cbm-instructions/evolition/images/Innenaufbau_obere_Box/Innenaufbau_obere_Box.jpg

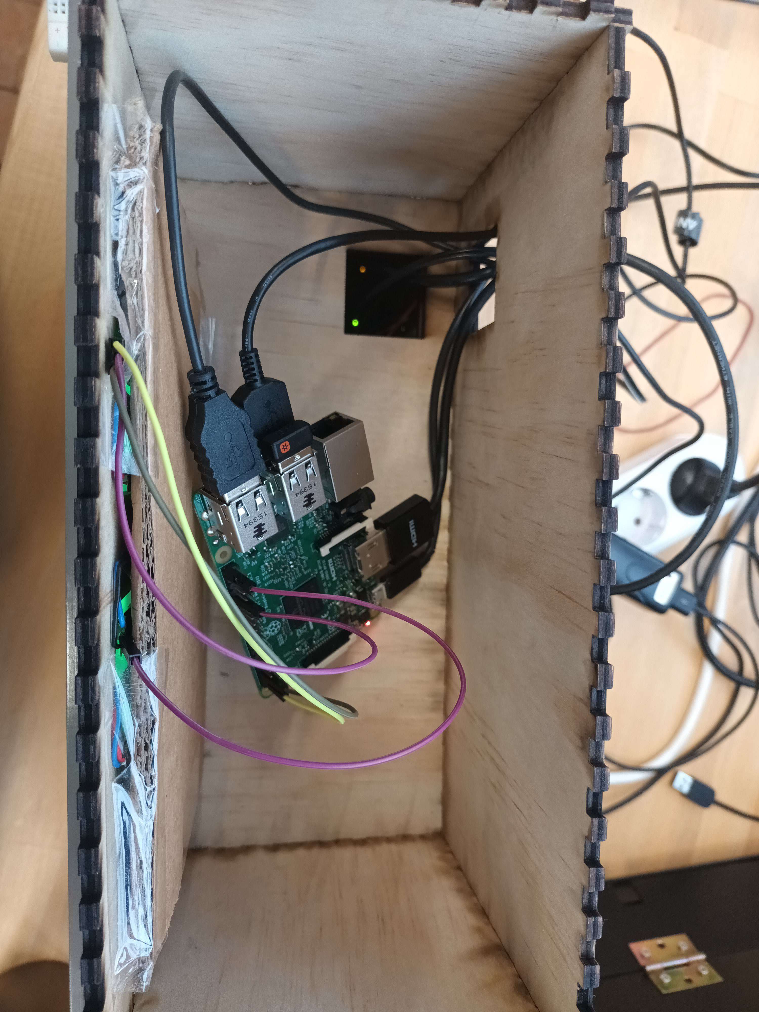
images/Innenaufbau_obere_Box/Innenaufbau_obere_Box.jpg
