cbm-instructions/evolition/Software/WeimosD1Mini/PeopleCounterFirmware/Config.h

#ifndef CONFIG_H
#define CONFIG_H

#define DEFAULT_PEOPLE_LIMIT 50
#define MOUNTED_INSIDE

/***   WiFi   ***/
//#define AP_MODE Does not work reliably
#define STASSID "name"
#define STAPSK "password"

/***   Debugging Mode   ***/
#define DEBUG_COUNTER

#endif
