cbm-instructions/evolition/Software/RaspberryPi/getExamTables.py

#!/usr/bin/env python3
import requests
import pandas as pd
import pdfplumber
import os 
import glob 


path = os.getcwd() + '/examTables/'


def getExamIB():
    url = 'https://services.informatik.hs-mannheim.de/pruefungsplan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'
    field = 'IB.pdf'
    getExamTable(url, field)
    getExamCSV(field)
    

def getExamCSB():
    url = 'https://services.informatik.hs-mannheim.de/pruefungsplan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'
    field = 'CSB.pdf'
    getExamTable(url, field)
    getExamCSV(field)
    

def getExamIMB():
    url = 'https://services.informatik.hs-mannheim.de/pruefungsplan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'
    field = 'IMB.pdf'
    getExamTable(url, field)
    getExamCSV(field)
    

def getExamUIB():
    url = 'https://services.informatik.hs-mannheim.de/pruefungsplan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'
    field = 'UIB.pdf'
    getExamTable(url, field)
    getExamCSV(field)
    

def getExamIMaster():
    url = 'https://services.informatik.hs-mannheim.de/pruefungsplan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'
    field = 'IMa.pdf'
    getExamTable(url, field)
    getExamCSV(field)
    

def getExamTable(url, field):
    r = requests.get(url)
    with open('examTables/' + field, "wb") as f:
        f.write(r.content)


def getExamCSV(field):
    pdf = pdfplumber.open(path + field)

    for i in range(3):
        table = pdf.pages[i].extract_table()
        df = pd.DataFrame(table[1::], columns=table[0])
        df.to_csv(path + '/week' + field[:-4]+ str(i+1) +'Exam.csv')

getExamCSB()
getExamIB()
getExamIMaster()
getExamIMB()
getExamUIB()
